HateFindingNames/nICE.Cube/__MAIN_FILE.tex

\documentclass[paper=a4,11pt,titlepage,twoside=true,headings=normal,numbers=noenddot,captions=tableabove,listof=totoc,index=totoc,bibliography=totoc]{scrreprt}
%-----------------------------------------------------------------
\usepackage{etoolbox}
\newbool{deutsch}
\booltrue{deutsch}
%-----------------------------------------------------------------
\input{pre-packages}
\input{pre-variables}
\input{pre-newcommand}
\input{pre-page-layout}
\input{pre-header-footer-2010}
\input{pre-header-footer-text-report}
\DeclareNameAlias{author}{family-given}
\DeclareNameAlias{editor}{family-given}
\DeclareNameAlias{translator}{family-given}
\addbibresource{quellen.bib}
\begin{document}
	%-----------------------------------------------------------------
	\input{chapters/0_top}
	\tableofcontents
	\clearpage
	%-----------------------------------------------------------------
	\input{chapters/1_chap}
	\input{chapters/2_chap}
	\input{chapters/3_chap}
	% \input{chapters/4_chap}
	% \input{chapters/5_chap}
	% \input{chapters/6_chap}
	% \newcommand{\chaptercount}{1} % put number of chapters here
	% \foreach \c in {1,...,\chaptercount}{\input{chapters/\c_chap}}
	%-----------------------------------------------------------------
	% \newpage
	% \listoffigures
	% \listoftables
	% \input{chapters/glossary}
	\appendix
	\input{chapters/appendixA}
	\input{chapters/appendixB}
	\printbibliography
	%=================================================================
\end{document}
