HateFindingNames/nICE.Cube/chapters/1_chap.tex

%LTeX: language=DE-de
\chapter{Zielformulierung}
	Hygienisches, schockabsorbierendes und handliches Kühltransportgefäß mit autarker Energieversorgung und Temperaturregelung für mechanisch und/oder thermisch
	empfindliches medizinisches Transportgut. Es verfügt über eine integrierte Kühllösung, die Temperaturen im Innenbereich von \SI{-20}{\celsius} über
	\(\geq \SI{48}{\hour}\) aufrecht erhalten kann und dabei durch seine kompakte Bauweise von einer einzelnen Person transportiert werden kann.\par\medskip
	Medizinisches Transportgut ist hier im Sinne der des \textit{Medizinischen Produkte Gesetzes} zu verstehen \cite{MPG}.
