HateFindingNames/nICE.Cube/chapters/appendixB.tex

\chapter{Zeichnungen}
	\begin{figure}[h]
		\centering
		
		\caption[Äußere Dimensionen]{Äußere Dimensionen des \textit{nICE.cube}.}
		\label{fig:zeichnung aussen}
	\end{figure}
	\clearpage
	\begin{figure}[h]
		\centering
		
		\caption[Explosionsansicht]{Explosionsansicht und Positionsnummern der Kernkomponenten.}
		\label{fig:explo}
	\end{figure}
	\clearpage
	\begin{figure}[h]
		\centering
		
		\caption[Detailzeichnung des Kühlbehälters.]{Detailzeichnung des Kühlbehälters.}
		\label{fig:nutzvolumen zeichnung}
	\end{figure}
