HateFindingNames/nICE.Cube/Konstruktionsbericht nICE.cube.pdf

HOCHSCHULE RHEINMAIN

### BAUELEMENTE FÜR ENERGIESYSTEME

## Zielformulierung und Konzipierung

## nICE.Cube (Arbeitstitel)

Autoren

CIHAN ÜNLÜ

DENNIS HUNTER

KONSTANTINOS AGLOUPAS

FACHBEREICH INGENIEURWISSENSCHAFTEN

STUDIENBEREICH ANGEWANDTE PHYSIK & MEDIZINTECHNIK

Datum: 31. Juli 2021

## Inhaltsverzeichnis

1 Zielformulierung | 3
2 Produktbeschreibung | 4
3 Detaillierung | 6
A Anhang A | 8
B Zeichnungen | 16
Literatur | 20

## 1 Zielformulierung

Hygienisches, schockabsorbierendes und handliches Kühltransportgefäû mit autarker Energieversorgung und Temperaturregelung für mechanisch und/oder thermisch empfindliches medizinisches Transportgut. Es verfügt über eine integrierte Kühllösung, die Temperaturen im Innenbereich von −20 °C über ≥ 48 h aufrecht erhalten kann und dabei durch seine kompakte Bauweise von einer einzelnen Person transportiert werden kann.
Medizinisches Transportgut ist hier im Sinne der des Medizinischen Produkte Gesetzes zu verstehen [2].

## 2 Produktbeschreibung

Das Transportgefäû -nICE.cube‹ dient dazu, empfindliches Transportgut aus dem medizinischen Bereich mit erhöhten Ansprüchen an die Transportumgebung in ihrem 17 L fassenden Innenraum gekühlt zu lagern. Bedingt durch die hervorragende thermische Dämmung aus Graphen-Aerogel ist das Produkt in der Lage, bei 40 °C Auûentemperatur eine Innentemperatur von −20 °C unter Abwesenheit einer aktiven Kühlung über einen Zeitraum von 5 h ohne kritischen Temperaturanstieg zu halten.
Eine aktive Kühlung wird durch einen 12 V Kompressor vom Typ CASCADE des Herstellers MASTER-FLUX bereit gestellt. Die Spannungsversorgung erfolgt im Stützbetrieb wahlweise durch Anbindung per Kaltgerätesteckverbindung an ein 230/110 V 50/60 Hz AC Netz oder eine 12 V-24 V Gleichstromquelle.

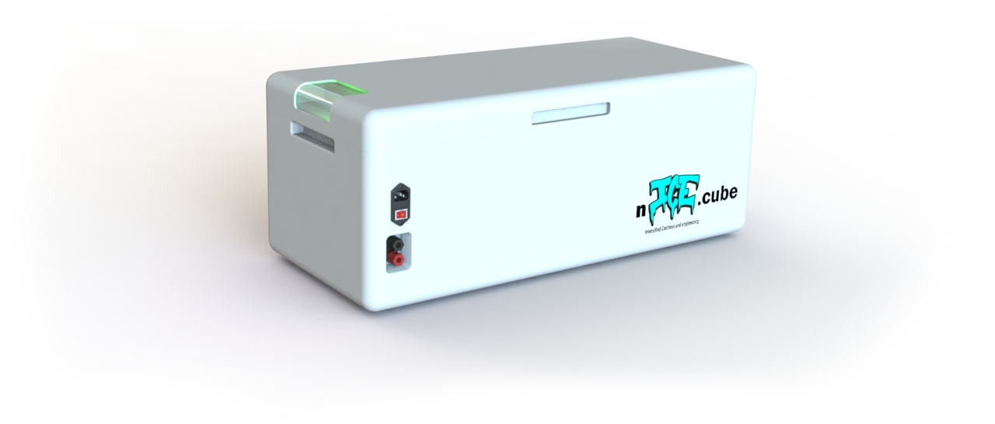
[picture p2: figure]

Abb. 2.1: Transport- und Kühleinheit nICE.cube.

Um einen autarken Betrieb von mindestens 48 h aufrecht zu erhalten ist ein 74W h Li-Ion-Akku verbaut. Um im mobilen Einsatz auch bei längeren Transportwegen die Kühlung sicher gewährleisten zu können, kann das Produkt von anderen -nICE.cube‹ parallel versorgt oder durch das mitgelieferte Photovoltaikmodul, welches eine Spitzenleistung von 250Wp liefert, gespeiût werden.
Am besonders energieeffizienten eInk-Display lassen sich jederzeit Parameter wie Innentemperatur, Akkustand Auûentemperatur oder geschätze Restlaufzeit¹ kontrollieren. Erreicht der Innenbereich eine vom Benutzer gesetzte kritische Temperatur oder einen niedrigen Akkustand wird über sich am Display befindliche Pieper und LEDs wahlweise akustisch und/oder visuell alarmiert.
Während die Schalung aus ABS-Kunststoff Komponenten wie Elektronik, Akku und Kompressor vor mechanischen Umwelteinflüssen schützt, sorgt die Schock- und Vibrationsdämpfende Aufhängung des Innenbereichs für einen sicheren Transport auch im Gelände.

1
In Abhängigkeit der historischen Auûentemperatur und momentanem Akkustand.

Hochschule RheinMain

## 2.1 Technische Daten

Die technischen Daten des -nICE.cube‹ im Überblick:

Tab. 2.1: Technische Daten

Mechanisch
Äuûere Dimensionen | 813 x 358 x 314 (LxBxH, Einheiten in mm)
Nutzvolumen | 16, 72 L
Gesamtgewicht | 22 kg

Elektrisch
Kapazität Akku | 72W h
Versorgungsspannung AC | 230/110 V 50/60 Hz
Versorgungsspannung DC | 12 − 24 V
Kühlleistung | 27, 65W [6]
Studienbereich Angewandte Physik & Medizintechnik | 5 von 20

## 3 Detaillierung

Die Transporteinheit nICE.cube erfüllt den Zweck, Krisengebiete mit extremen Wetterbedingungen mit Medikamente und Impfstoffe zu versorgen, indem das Kühlgut sicher transportiert werden kann.
Die Kühlung des Nutzvolumens erfolgt durch eine Kompressionskälteanlage mit einer maximalen Kühlleistung von 27, 65W. Die zentrale Komponente bildet hier ein Kompressor der CASCADE-Serie des Herstellers Masterflux ± ein in seiner Klasse besonders energieeffizientes und spezifisch für den Einsatz im medizinischen Sektor entwickeltes Gerät.
Die hervorragende thermische Isolation des Primärvolumens durch Graphen-Aerogel (vgl. table A.4) reduziert die Betriebszeiten der Kälteanlage und damit den Energiebedarf des nICE.cube auf ein Minimum. Zum autarken Betrieb ist ein Energiespeicher bestehend aus 32 Li-Ion-Zellen der Bauform 18650 verbaut. In 4S8P-Konfiguration liefern sie eine nominelle Versorgungsspannung der Systemkomponenten von 14, 8 V bei einer Gesamtkapazität von 296W h 1
. Die bereits geringe Belastung des Energiespeichers durch Entladeströme je Zelle bei Volllast von ≈ 0, 25 A wird durch thermische Überwachung jeder Einzelzelle garantiert. Über die Lebensdauer hinweg werden Lade- und Entladezyklen sowie Ströme und Spannungsverläufe aufgezeichnet, um die Nutzenden jederzeit über den Zustand des Akkus informieren zu können.
Die Ladung erfolgt wahlweise stationär durch das lokale AC-Versorgungsnetz oder im mobilen Einsatz durch Anschluss eines Photovoltaikmoduls. Die äuûeren Dimensionen des nICE.cube betragen (813×358×
314) mm (LxBxH). Als Nutzvolumen steht mit Abmessungen von ≈ (400 × 248 × 173) mm ein Volumen von 16, 72 L zur Verfügung.

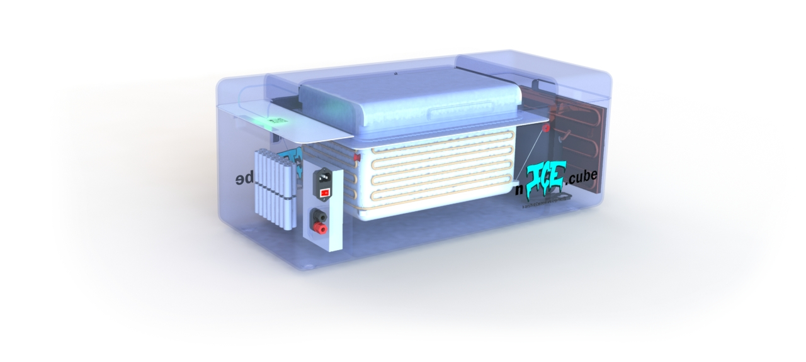
[picture p3: figure]

Abb. 3.1: Konzeptansicht des nICE.cube mit Blick auf die innenliegenden Komponenten.

1Reduktion durch Verschleiû/Nutzungsverhalten möglich.

## 3.1 Stückliste

Tab. 3.1: Stückliste (vgl. fig. B.2)

Pos. | Menge Einheit Benennung | Bemerkung
1 | 1 | Stk. | Ansaugverbindung
2 | 4 | Stk. | Aramidschnur
3 | 1 | Stk. | Druckreduzierer
4 | 2 | Stk. | Durchführung
5 | 1 | Stk. | Dämpfer
6 | 1 | Stk. | E-Ink Display | 1.54"
7 | 1 | Stk. | Ein-/Ausgabepanel
8 | 4 | Stk. | Elektronik
9 | 1 | Stk. | Elektronikdeckel
10 | 1 | Stk. | Gummimanschette
11 | 1 | Stk. | Hülle
12 | 1 | Stk. | Kompressor | CASCADE17-0146Y1
13 | 1 | Stk. | Kompressordeckel
14 | 1 | Stk. | Kältemittelverbindung von
| | | Verflüssiger
15 | 1 | Stk. | Kältemittelverbindung zu
| | | Verflüssiger
16 | 32 | Stk. | Li-Ion 18650 | 4S8P Konfiguration
17 | 1 | Stk. | Reduzierer
18 | 1 | Stk. | Transportgutbehälter
19 | 1 | Stk. | Trockner
20 | 1 | Stk. | Verflüssiger
21 | 1 | Stk. | Verschlussdeckel auûen
22 | 1 | Stk. | Verschlussdeckel innen
23 | 1 | Stk. | DC-Anschluss | Buchse für 4, 2 mm Laborstecker mit
| | | | Polschraube (Bipolar)
24 | 1 | Stk. | AC-Anschluss | C14 AC Buchse mit Schalter und Si-
| | | | cherungshalter

## A Anhang A

## A.1 Pflichtenheft

Tab. A.1: Liste mit Festanforderungen.

Festanforderungen | Erläuterung
Hygienisch | Das Material muss Kontamination durch Verkeimung
| oder Ähnlichem weitestgehend unterbinden. Die Geo-
| metrie muss eine einfache und gründliche Reinigung
| ermöglichen.
Thermisch geregelt | Die Innentemperatur muss einstellbar sein und einem
| Regelkreis unterliegen.
Thermische Isolierung | Die innere Temperatur muss weitgehend stabil gehal-
| ten werden.
Autarke Energieversorgung | Erneuerbare Energien nutzend muss das Gerät über ei-
| ne eigene Spannungsversorgung verfügen.
Integrierter Energiespeicher | Im Offline-Betrieb und bei Ausfall der eigenen Span-
| nungsversorgung muss das Produkt betriebsfähig blei-
| ben.
Cradle-to-cradle | Sämtliche verbauten Komponenten müssen einem
| biologischen oder technischen Kreislauf zurückge-
| führt werden können.
Kompakte und leichte Bauweise | Das Produkt muss beladen von einer Einzelperson
| transportiert werden können.
Schockfreie Lagerung des Inhalts | Der Nutzraum muss von starken Erschütterungen ent-
| koppelt sein.
Alarmierung bei kritischer Temperatur | Die Nutzenden müssen über kritische Temperaturzu-
| stände informiert werden.
Alarmierung bei kritischem Akkustand | Die Nutzenden müssen über kritische Energieversor-
| gung informiert werden.

Tab. A.2: Liste nicht zu unter- oder gegebenenfalls überschreitender Parameter.

Mindestanforderungen | Erläuterung
Kühlung ≤ (−20 ± 1) °C | Der Innenraum muss auf mindestens −20 °C herun-
| tergekühlt werden können.
Temperaturstabil ≥ 48 h | Die Temperatur muss min. 48 h lang gehalten werden.
Gewicht ≤ 20 kg | Die Box soll ein Leergewicht von max. 20 kg besit-
| zen.

## A.2 Marktforschung

Es wurden Marktforschungen betrieben, um eine Übersicht der konkurrierenden Kühlboxen zu erhalten.

Tab. A.3: Liste von Eigenschaften, die das Produkt im Rahmen der Machbarkeit weiterhin aufweisen könnte.

Wunschanforderungen | Erläuterung
Innenbeleuchtung | Bei schlechter Auûenbeleuchtung sollte der Inhalt
| dennoch gut erkennbar sein.
Statusanzeige | Die Nutzenden sollen sich jederzeit über den Status
| des Produktes ± Temperatur, Leistungsaufnahme und
| -abgabe, Restkapazität ± informieren können.
Modularer Aufbau | Einzelne funktionale Komponenten sollen leicht aus-
| tauschbar sein.
Verbundbetrieb | Mehrere der Produkte sollen im Verbund betrieben
| werden können. Hierzu zählt Stützbetrieb einzelner
| Geräte durch andere, sowie gesammelte Statusanzei-
| ge.
Kompatibilität verschiedener ext. Span- nungsversorgungen | Das Gerät soll an möglichst vielen verschiedenen
| externen Versorgungsspannungen betrieben werden
| können.

T0022 FDN von EBERSPÄCHER (https://www.eberspaecher-klima.de/fileadmin/data/corporatesite/pdf/de/4_air_conditioning/gp/fh_gp_kuehlcontainer_de.pdf)

- Temperatur von −24 °C
- Spannung 12 V / 24 V DC
- (65 − 70) mm PU Wandausschämung
- Kältemittel R134a (Tetrafluorethan)
- Gewicht von 20, 5 kg
- Auûenabmessung 375 x 585 x 480 (BxTxH, Einheiten in mm)

ICY 20 von FRIGOLAB COLD TECHNOLOGY (https://www.frigolab.eu/gb/dometic-portable-freezers/67-icy-20.html)

- Temperaturen von −18 °C bis 10 °C.
- Auûenabmessung 515 x 345 x 425 (BxTxH, Einheiten in mm).
- Digitales Display.
- Kühlung durch einen Kompressor.
- Kältemittel R134a (Tetrafluorethan).
- Versorgung von 12 V / 24 V DC oder 230 V AC.
- Gewicht von 18 kg.
- Resistent gegen Schock und mechanische Belastungen.
- CFC- und HCF-freie Polyurethanschaum.

TC 702 von TRITEC (https://www.tritec-klima.de/datenblaetter/de/kaelte/portable/TD-TC702.pdf)

- Temperaturen von −24 °C bis 10 °C.

- Auûenabmessung 375 x 585 x 480 (B x T x H, Einheiten in mm).
- Durch Autobatterie mit 12 V / 24 V DC betrieben.
- Umschalter für Netzbetrieb (230 V AC).
- Stabiler und stoûfester UVA-beständiger Kunststoff.
- Deckel mit spezieller Verriegelung.
- Dämmung mit FCKW-feiem PU-Hartschaum von 80 mm Dicke.
- Reinigungsmittelresistent.
- Alarmmeldungen bei möglichen Fehlern des Gerätes.
- Kompressor mit einem R52A Kältemittelgemisch.

T0022/T0032 von COLDTAINER (https://coldtainerusa.com/wp-content/uploads/2020/03/Product_Info_T0022-T0032_US_ColdtainerUSA-1.pdf)

- Temperatur von −24 °C bis 40 °C
- Spannungsversorgung 12 / 24 V DC
- (65 − 70) mm PU-Wandausschämung
- Kältemittel R134a (Tetrafluorethan)
- Gewicht von 20, 5 kg
- ≈ 23 L Kapazität

## A.3 Mindmap

Nach den ersten Überlegungen zu den Anforderungen und Funktionen des Transportgefäûes kann eine Übersicht anhand eines Mindmaps wie in Abb. A.1 gestaltet werden.

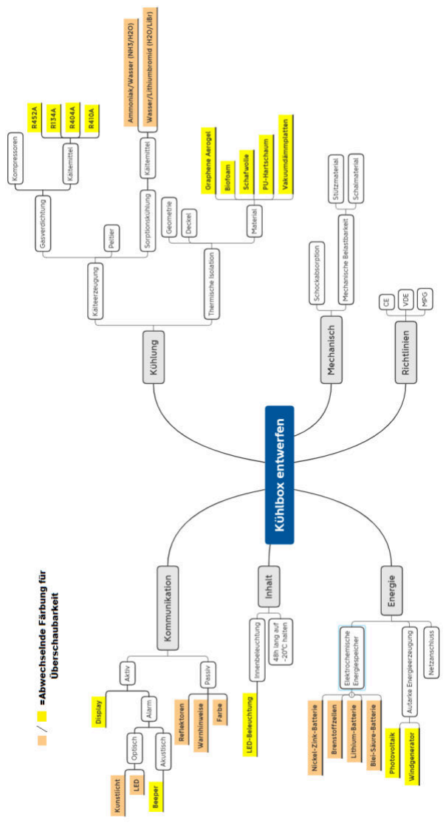
[picture p4: figure]

Abb. A.1: Mindmap.

## A.4 Materialien und Regularien

A.4.1 Normen und Regularien

Dem BUNDESINSTITUT FÜR ARZNEIMITTEL UND MEDIZINPRODUKTE zu Folge ist „ein Absehen von
der Genehmigung einer klinischen Prüfungª [1] möglich, wenn das Produkt etwa den Medizinprodukten der Klasse I zuzuordnen ist [2]. Die Klassifizierung von medizinischen Produkten wiederum ist durch die
Richtlinie 93/42/EWG geregelt. In Anhang IX ist zu lesen:

„Alle nicht invasiven Produkte gehören zur Klasse I [..]ª [3]

mit Ausnahme derer nicht-invasiven Produkte, die in folgenden Punkten aufgeführten Regelungen Anwendung finden. Es ist anzunehmen, dass dies hier nicht der Fall ist.

Dennoch handelt es sich um ein Gerät, dass, um für den europäischen Markt zugelassen werden zu können eine CE-Kennzeichnung benötigt und somit die damit verbundenen Auflagen erfüllen muss. Die relevante Norm scheint hier DIN EN 60601.
Weiter wird eine VDE-Kennzeichnung benötigt, da es sich um ein in einer Form elektrisch betriebenes Gerät handelt. Dies wird um so relevanter, wenn ein Betrieb an Netzspannung möglich oder vorgesehen ist.

A.4.2 Auswahl Dämmmaterialien

Tab. A.4: Übersicht möglicher Materialien zur thermischen Dämmung.

(Handels-)Name | λ/ mW m·K | ρ/ mg
cm³ | E-Modul / kP a Druckfestigk. / kP a
Luft | 25, 7 | 1, 2041 | ± | ±
Graphen/Silizium Aerogel [5] 7, 3 ± 9 | (2, 4 ± 4)·10³
Biofoam (Algen) [7] | | 30
Biobasiertes PU [4] | 33 | 18, 5 | 176, 7 | 15, 4
Air laid feather fibre [10] | 30¹ | | | > 30²
Vakuumdämmplatte [8] | 37 ± 31 16, 3 ± 59, 4

1Bei −10 °C
2Nach 10 minütigem Eintauchen in flüssigen Stickstoff (−195 °C)

## A.5 Überschlagsrechnung Energiebedarf

Annahme: 20 L Innenraum; zu 80 % gefüllt mit Wasser (16 L=16 kg b )

Betrachtung: Energien beim Herunterkühlen von Wasser bei RT (20 °C = 293 K) auf −20 °C = 253 K

Je kg umgewandelte Wärmeenergie = Änderung der spezifischen Enthalpie:

Für 20 °C → 0 °C:

∆h1 =

∆Q1
m

= cW asser · (T0 − T20) = 4, 19

kJ
kg K | (A.1)

= −83

kJ
kg | (A.2)

Zum Erstarren:

∆h2 = herstarr,W asser = −hfus,W asser
= −334 kJ
kg | (A.3)

Für 0 °C → −20 °C:

∆h3 = cEis · (T−20 − T0) = 2, 0

kJ
kg K · (253 K − 273 K)

= −40 kJ
kg | (A.4)

∆hges = ∆h1 + ∆h2 + ∆h3 = −83, 8

kJ

kg − 334 kJ

kg − 40 kJ
kg = −457, 8

kJ
kg

⇒ ∆Qges = ∆hges · m = −457, 8

kJ
kg · 16 kg
= −7324, 8 kJ ≈ −7, 3 MJ | (A.5)

Benötigte Energie, um eine Temperaturdifferenz aufrechtzuerhalten:
Mit einer Schichtdicke des thermischen Isoliermaterials von l = 0, 05 m, der Gesamtfläche A des Kühlraums von ≈ 0, 208 m² und einer thermischen Leitfähigkeit von λ = 7, 3

mW
| m K lässt sich der thermische
Widerstand zu Rth ≈ 33 K
W abschätzen.

Rth =

l
λ · A

=

0, 05 m
7, 3

mW
m K · 0, 208 m²

≈ 33

K
W
| (A.6)

Q˙ = P =

(Taussen − Tinnen)

Rth

=

313, 15 K − 253, 15 K

### 33 K

W
≈ 1, 81W | (A.7)
⇒ ≈ 87, 27W h | (Für 48 h)

Bei einer Auûentemperatur von 40 °C und einer Anfangsinnentemperatur von −20 °C mit der Annahme, dass 33 % des Nutzvolumens von 16, 72 L mit Wasser und 66 % mit Luft gefüllt sind, wird von einer Dauer von tkrit = 14, 2 h ausgegangen, bis sich der Innenraum um 2 K erwärmt hat.

tkrit =

∆T
Q˙
- [(0, 66 · ρaqV · caq) + (0, 33 · ρluftV · cluft)]

=

### 2 K

1, 81W

·

- 0, 66 · 1000
kg
m³
- 0, 0167 m³
- 4200 J

kg K

+

0, 33 · 1, 225

kg
m³
- 0, 0167 m³
- 1005

J

kg K

≈ 51.159 s ≈ 14, 2 h | (A.8)

∆T =

∆Q
0, 66 · ρaqV · caq

=

1, 81W · 5 h · 3600 s
h
0, 66 · 997 kg
m³ · (16, 72 · 10⁻³) m³ · 4200 J
kg K
≈ 0, 7 K | (A.9)

## A.6 Dimensionierung Photovoltaikmodul

Mithilfe der Photovoltaik kann der Akku bei Tageslicht geladen und die Kühlung somit aufrecht erhalten werden. Hierbei ist einem monokristallines PV-Modul bei einer Fläche von 9 m²
eine Spitzenleistung von
mindestens 1 kWp zu entnehmen [9]. Zum Betrieb des nICE.cube und Laden seines Energiespeichers ist ein Viertel der Leistung (=250W b p) ausreichend. Dies entspricht einer effektiven Fläche von 2, 25 m²

## A.7 Volumenberechnung

Das Nutzvolumen setzt sich aus der Länge L, Breite B und Höhe H der inneren Box zusammen.

Vnutz = L · B · H
= 4, 00 dm · 2, 48 dm · 1, 73 dm
= 17, 16 L | (A.10)

Im Sinne thermischer und mechanischer Optimierung wurden Verrundungen mit r = 4 mm entlang der Innenkanten des Nutzvolumens platziert. Diese reduzieren das effektive Nutzvolumen auf 16, 72 L.

## A.8 Elektronik

Die Verbindung der jeweiligen Elektronikkomponenten wird in fig. A.2 schematisch dargestellt.

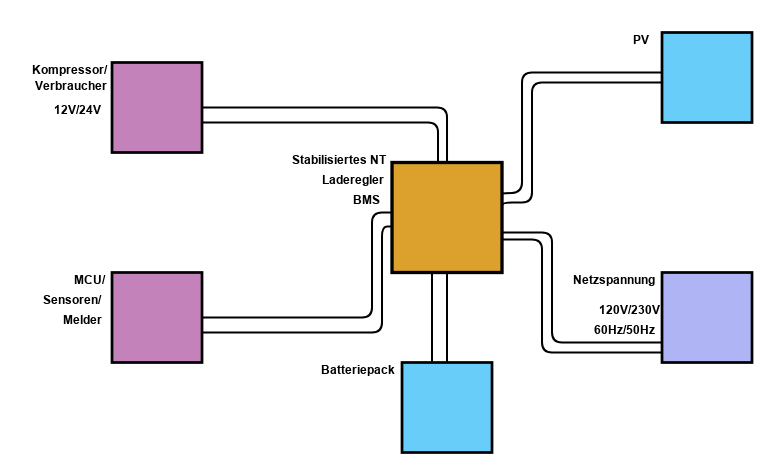
[picture p5: figure]

Abb. A.2: Schaltschema der Elektronik.

Sowohl die interne als auch sämtliche externe Spannungsversorgungen werden vom internen Netzteil auf den Lastkreis von 12 V, sowie die Versorgungsspannung der Boardelektronik geregelt. Das im Netzteil integrierte Batteriemanagement übernimmt hierbei die Überwachung des Akkuzustandes. Daten wie Auûenund Innentemperatur, Temperatur der Akkuzellen, Statistiken zum Zustand des Akkus etc. laufen zentral im

Mikrocontroller zusammen, werden dort verarbeitet und gegebenenfalls an die Meldesysteme weitergegeben.
Um Raum einzusparen und das Kühlkonzept der Boardelektronik zu vereinfachen wurden in der Realisierung Mikrocontroller, Batteriemanagement und Netzteil in einem Bauteil vereint (Pos. 8 in table 3.1).

## B Zeichnungen

# Hochschule RheinMain 813

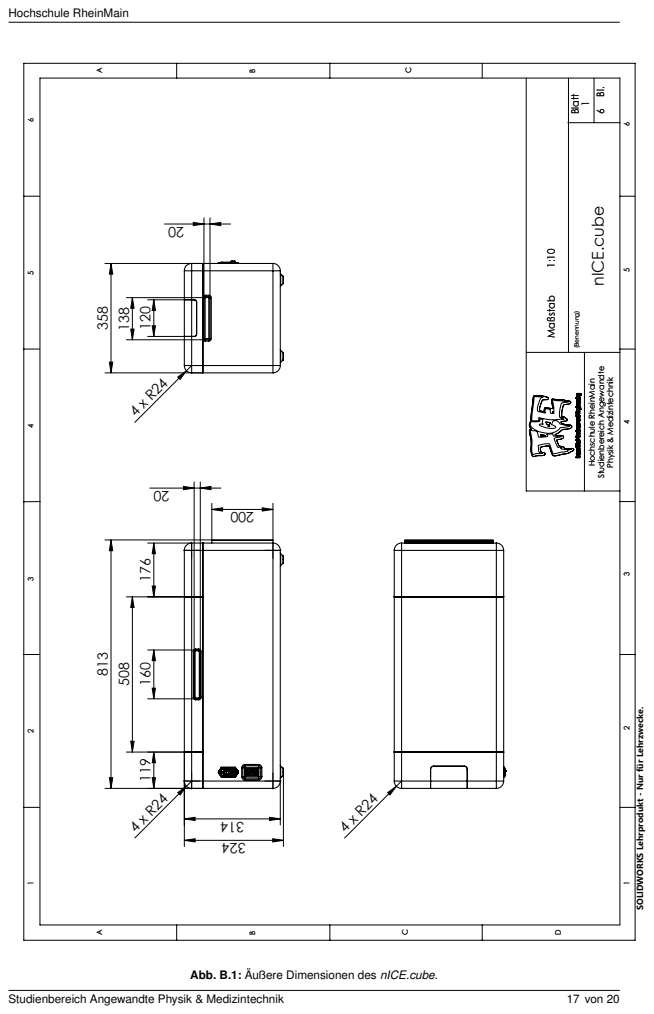
[picture p6: page 17]
Maßstab 1:10; Hochschule RheinMain; Studienbereich Angewandte Physik & Medizintechnik; (Benennung) Blatt; nICE.cube

SOLIDWORKS Lehrprodukt - Nur für Lehrzwecke.

Abb. B.1: Äuûere Dimensionen des nICE.cube.

5

22 19

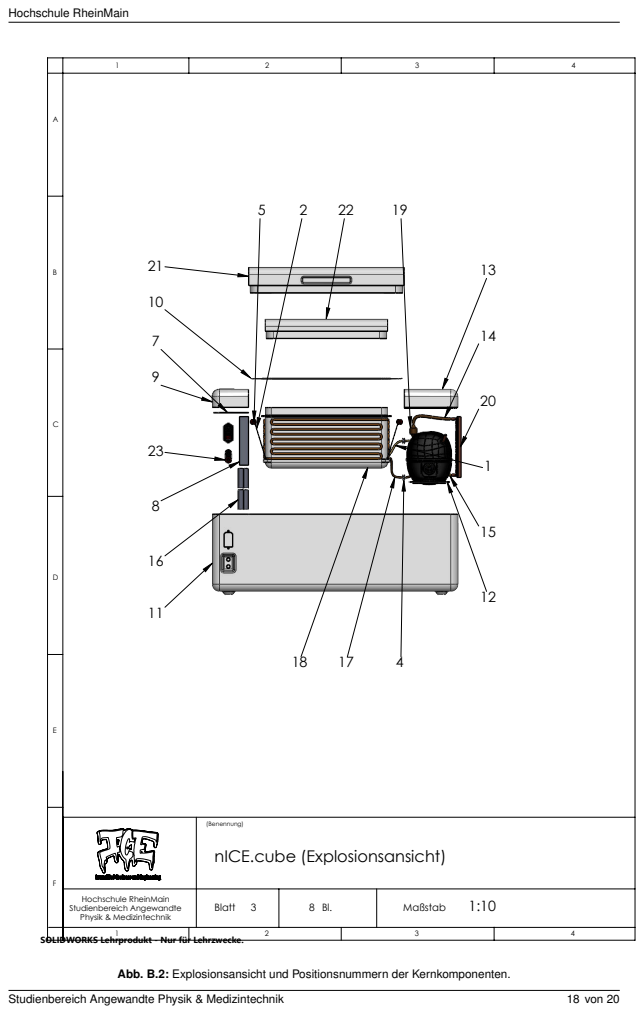
[picture p7: page 18]
Maßstab; Blatt

(Benennung)
nICE.cube (Explosionsansicht)

Hochschule RheinMain
Studienbereich Angewandte
Physik & Medizintechnik
SOLIDWORKS Lehrprodukt - Nur für Lehrzwecke.

Abb. B.2: Explosionsansicht und Positionsnummern der Kernkomponenten.

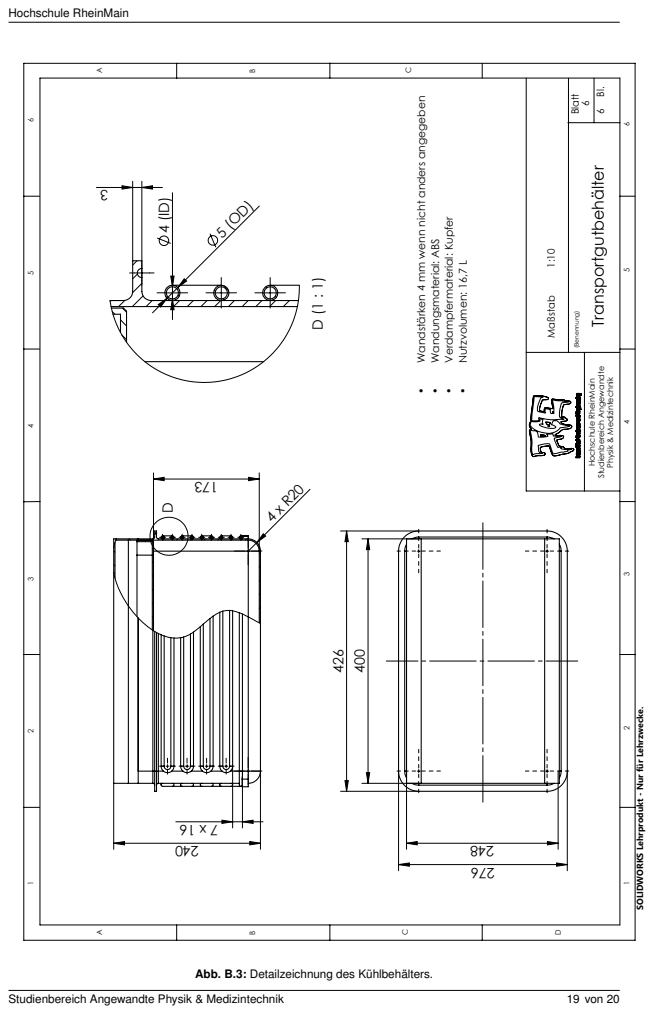
[picture p8: page 19]
Wandungsmaterial: ABS •; Verdampfermaterial: Kupfer •; Nutzvolumen: 16,7 L •; Maßstab 1:10; Hochschule RheinMain; Studienbereich Angewandte Physik & Medizintechnik; (Benennung) Blatt; Transportgutbehälter

Wandstärken 4 mm wenn nicht anders angegeben •

SOLIDWORKS Lehrprodukt - Nur für Lehrzwecke.

Abb. B.3: Detailzeichnung des Kühlbehälters.

## Literatur

[1] BfArM. Antrag auf Absehen von der Genehmigungspflicht. URL: https://www.bfarm.de/DE/Medizinprodukte/KlinischePruefung/AbsehenVonDerGenehmigungspflicht/
_node.html (https://www.bfarm.de/DE/Medizinprodukte/KlinischePruefung/AbsehenVonDerGenehmigungspflicht/_node.html) (besucht am 07. 05. 2021).
[2] Bundesrepublik Deutschland. Medizinische Produkte Gesetz. MPG. 7. Mai 2021. URL: https://
www.gesetze-im-internet.de/mpg/index.html#BJNR196300994BJNE001903377
(besucht am 07. 05. 2021).
[3] European Council. Council Directive 93/42/EEC. Version 1993L0042 Ð EN Ð 11.10.2007 Ð 005.001.

### 14. Juni 1993. URL: https://eur-lex.europa.eu/legal-content/EN/TXT/?qid=

1620368811646&uri=CELEX%3A01993L0042-20071011 (https://eur-lex.europa.eu/legal-content/EN/TXT/?qid=1620368811646&uri=CELEX%3A01993L0042-20071011) (besucht am 05. 05. 2021).
[4] Huang, X., Qi, J., De Hoop, C., Xie, J., and Chen, Y. Biobased polyurethane foam insulation from mi-
crowave liquefaction of woody underbrush. NC State University, 2017. URL: https://bioresources.cnr.ncsu.edu/wp- content/uploads/2017/09/BioRes_12_4_8160_Huang_ QHXC _ Biobased _ PU _ Foam _ Insulation _ Liquefaction _ Woody _ Underbrush _
12704.pdf (https://bioresources.cnr.ncsu.edu/wp-content/uploads/2017/09/BioRes_12_4_8160_Huang_QHXC_Biobased_PU_Foam_Insulation_Liquefaction_Woody_Underbrush_12704.pdf) (besucht am 02. 05. 2021).
[5] Lei, Yaofei u. a. „Enhancements of thermal insulation and mechanical property of silica aerogel monoliths by mixing graphene oxideª. In: Materials Chemistry and Physics 187 (2017). PII: S0254058416308975,
S. 183±190. ISSN: 02540584. DOI: 10.1016/j.matchemphys.2016.11.064. (https://doi.org/10.1016/j.matchemphys.2016.11.064)
[6] Masterflux. Datenblatt CASCADE17-0146Y1. URL: https://www.masterflux.com/userimages/CASCADE17-0146Y1_DATA_SHEET.pdf (https://www.masterflux.com/userimages/CASCADE17-0146Y1_DATA_SHEET.pdf) (besucht am 27. 07. 2021).
[7] Morrison, Robert L. „Biofoam II. US19940215159;US19930043300ª. C08J9/00;C08J9/28;C08J9/26;C08J9/28. US5360828 (A) (US). UNIV CALIFORNIA. 1994.
[8] Nagarajan, Venkata S. und Grieco, William J. „VACUUM INSULATED PANEL. US201314067025ª. F16L59/07;B32B37/10;E04C2/02. US2015118434 (A1) (US). OWENS CORNING INTELLECTU-AL CAP. 2015.
[9] Wesselak, Viktor und Voswinckel, Sebastian. Photovoltaik. Wie Sonne zu Strom wird. ger. Technik im Fokus. Berlin: Springer Vieweg, 2012. 129 S. ISBN: 978-3-642-24297-7.
[10] Zhao, Yuanxiang, Dieckmann, Elena und Cheeseman, Christopher. „Low-temperature thermal insulation materials with high impact resistance made from feather-fibresª. In: Materials Letters: X 6 (2020). PII: S2590150820300028, S. 100039. ISSN: 25901508. DOI: 10.1016/j.mlblux.
2020.100039. (https://doi.org/10.1016/j.mlblux.2020.100039)
