HateFindingNames/nICE.Cube/pre-header-footer-text-report.tex

% le --> links, gerade Seite
% ce --> mittig, gerade Seite
% re --> rechts, gerade Seite
% lo --> links, ungerade Seite
% co --> mittig, ungerade Seite
% ro --> rechts, ungerade Seite
% even --> gerade Seite
% odd --> ungerade Seite
%----------------------------------------- Kopfzeilentext
 \newcommand{\titelkopfzeilemitteeven}{}
 \newcommand{\titelkopfzeilemitteodd}{}
 \newcommand{\titelkopfzeilelinkseven}{Hochschule RheinMain}
 \newcommand{\titelkopfzeilelinksodd}{Hochschule RheinMain}
 \newcommand{\titelkopfzeilerechtseven}{}
 \newcommand{\titelkopfzeilerechtsodd}{}
 %----------------------------------------- Fußzeilentext
 \newcommand{\titelfusszeilemitteeven}{}
 \newcommand{\titelfusszeilemitteodd}{}
 \newcommand{\titelfusszeilerechtseven}{\thepage \hspace{0.5mm} von \pageref{LastPage}}
 \newcommand{\titelfusszeilerechtsodd}{\thepage \hspace{0.5mm} von \pageref{LastPage}}
 \newcommand{\titelfusszeilelinkseven}{Studienbereich Angewandte Physik \& Medizintechnik}
 \newcommand{\titelfusszeilelinksodd}{Studienbereich Angewandte Physik \& Medizintechnik}
