HateFindingNames/nICE.Cube/chapters/5_chap.tex

%LTeX: language=DE
\chapter{Energieversorgung und -speicher}
{
\centering
\includepdf[pages=-]{Wartungsfreie_Batterien_und_PV.pdf}
}
