HateFindingNames/nICE.Cube/chapters old/2_chap.tex

% %LTeX: language=DE
% \chapter{Marktforschung}
%     Es wurden Marktforschungen gemacht, um bei den aktuellen Kühlboxen nach einen potenzielle Konkurrent zu finden.
%     \href{https://www.eberspaecher-klima.de/fileadmin/data/corporatesite/pdf/de/4_air_conditioning/gp/fh_gp_kuehlcontainer_de.pdf}{\textsc{Ebersprächer}}
%     \begin{figure}[h] %[H h t b]
%         \centering
%         \includegraphics[width=.5\textwidth]{referenzen/eberspächer.jpg}
%         \caption{Kühlbox t0022 FDN von Eberspächer}
%     \end{figure}
%     \href{https://www.frigolab.eu/gb/dometic-portable-freezers/67-icy-20.html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}{\textsc{FrigoLab cold technology}}
%     \begin{figure}[h] %[H h t b]
%         \centering
%         \includegraphics[width=.5\textwidth]{referenzen/FrigoLab.jpg}
%         \caption{Kühlbox ICY 20 von FrigoLab cold technology}
%     \end{figure}
%     \href{https://www.tritec-klima.de/datenblaetter/de/kaelte/portable/TD-TC702.pdf}{\textsc{Tritec}}
%     \begin{figure}[h] %[H h t b]
%         \centering
%         \includegraphics[width=.5\textwidth]{referenzen/tritec.jpg}
%         \caption{Kühlbox TC 702 von Tritec}
%     \end{figure}
%     \href{https://coldtainerusa.com/wp-content/uploads/2020/03/Product_Info_T0022-T0032_US_ColdtainerUSA-1.pdf}{\textsc{Coldtainer}}
%     \begin{figure}[h] %[H h t b]
%         \centering
%         \includegraphics[width=.5\textwidth]{referenzen/coldtainer.png}
%         \caption{Kühlbox T0022/T0032 von Coldtainer}
%     \end{figure}
%     \newpage
%     Bei der Marktforschung wird oft nicht angegeben über die Dauer der Kühlung und verlässt sich stark auf die Wärmedämmung des Inhalts. Von der momentane Auwashl
%     ist die Kühlbox von Tritec, die unsere Forerungen am ehesten erfüllt.

%LTeX: language=DE
\chapter{Marktforschung}
Es wurden Marktforschungen gemacht, um bei den aktuellen Kühlboxen nach einen potenzielle Konkurrent zu finden.\par\medskip

\textbf{T0022 FDN von} \href{https://www.eberspaecher-klima.de/fileadmin/data/corporatesite/pdf/de/4_air_conditioning/gp/fh_gp_kuehlcontainer_de.pdf}{\textsc{Eberspächer}}
\begin{figure}[H] %[H h t b]
    \centering
    
    \caption{Kühlbox t0022 FDN von \textsc{Eberspächer}.}
\end{figure}
\begin{itemize}
    \item Temperatur von \SI{-24}{\celsius}
    \item Spannung 12 / \SI{24}{V} DC
    \item \SI{(65-70)}{mm} PU Wandausschämung
    \item Kältemittel R134a (Tetrafluorethan)
    \item Gewicht von \SI{20,5}{kg}
    \item Außenabmessung \(\SI{(375 x 585 x 480)}{mm}\) (BxTxH)
\end{itemize}
\newpage
\textbf{ICY 20 von} \href{https://www.frigolab.eu/gb/dometic-portable-freezers/67-icy-20.html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}{\textsc{FrigoLab Cold Technology}}
\begin{figure}[H] %[H h t b]
    \centering
    
    \caption{Kühlbox ICY 20 von \textsc{FrigoLab Cold Technology}.}
\end{figure}
\begin{itemize}
    \item Temperaturen von \SI{-18}{\celsius} bis \SI{10}{\celsius}.
    \item Außenabmessung \SI{(515 x 345 x 425)}{mm} (BxTxH).
    \item Digitales Display.
    \item Kühlung durch einen Kompressor.
    \item Kältemittel R134a (Tetrafluorethan).
    \item Versorgung von 12 / \SI{24}{V} DC oder \SI{230}{V} AC.
    \item Gewicht von \SI{18}{kg}.
    \item Resistent gegen Schock und mechanische Belastungen.
    \item CFC- und HCF-freie Polyurethanschaum.
\end{itemize}
\newpage
\textbf{TC 702 von} \href{https://www.tritec-klima.de/datenblaetter/de/kaelte/portable/TD-TC702.pdf}{\textsc{Tritec}}
\begin{figure}[H] %[H h t b]
    \centering
    
    \caption{Kühlbox TC 702 von \textsc{Tritec}.}
\end{figure}
\begin{itemize}
    \item Temperaturen von \SI{-24}{\celsius} bis \SI{10}{\celsius}.
    \item Außenabmessung \SI{(375 x 585 x 480)}{mm} (B x T x H).
    \item Durch Autobatterie mit 12 / \SI{24}{V} DC betrieben.
    \item Umschalter für Netzbetrieb (\SI{230}{V} AC).
    \item Stabiler und stoßfester UVA-beständiger Kunststoff.
    \item Deckel mit spezieller Verriegelung.
    \item Dämmung mit FCKW-feiem PU-Hartschaum von \SI{80}{mm} Dicke.
    \item Reinigungsmittelresist.
    \item Alarmmeldungen bei möglichen Fehlern des Gerätes.
    \item Kompressor mit einem R52A Kältemittelgemisch.
\end{itemize}

\newpage
\textbf{T0022/T0032 von} \href{https://coldtainerusa.com/wp-content/uploads/2020/03/Product_Info_T0022-T0032_US_ColdtainerUSA-1.pdf}{\textsc{Coldtainer}}
\begin{figure}[H] %[H h t b]
    \centering
    
    \caption{Kühlbox T0022/T0032 von \textsc{Coldtainer}.}
\end{figure}
\begin{itemize}
    \item Temperatur von \SI{-24}{\celsius} bis \SI{40}{\celsius}
    \item Spannungsversorgung 12 / \SI{24}{V} DC %volt of direct current bzw. Gleichstrom
    \item \SI{(65-70)}{mm} PU Wandausschämung
    \item Kältemittel R134a (Tetrafluorethan)
    \item Gewicht von \SI{20,5}{kg}
    \item \(~ \SI{23}{L}\) Kapazität
\end{itemize}
