HateFindingNames/nICE.Cube/assets/skizzen/Mindmap.png

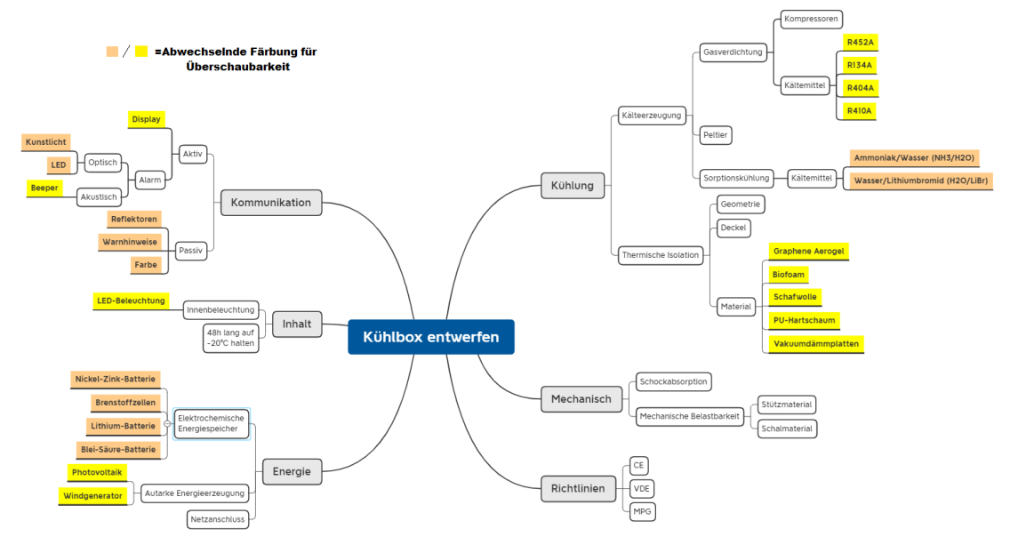
assets/skizzen/Mindmap.png
