HateFindingNames/nICE.Cube/Assembly/assy.SLDASM

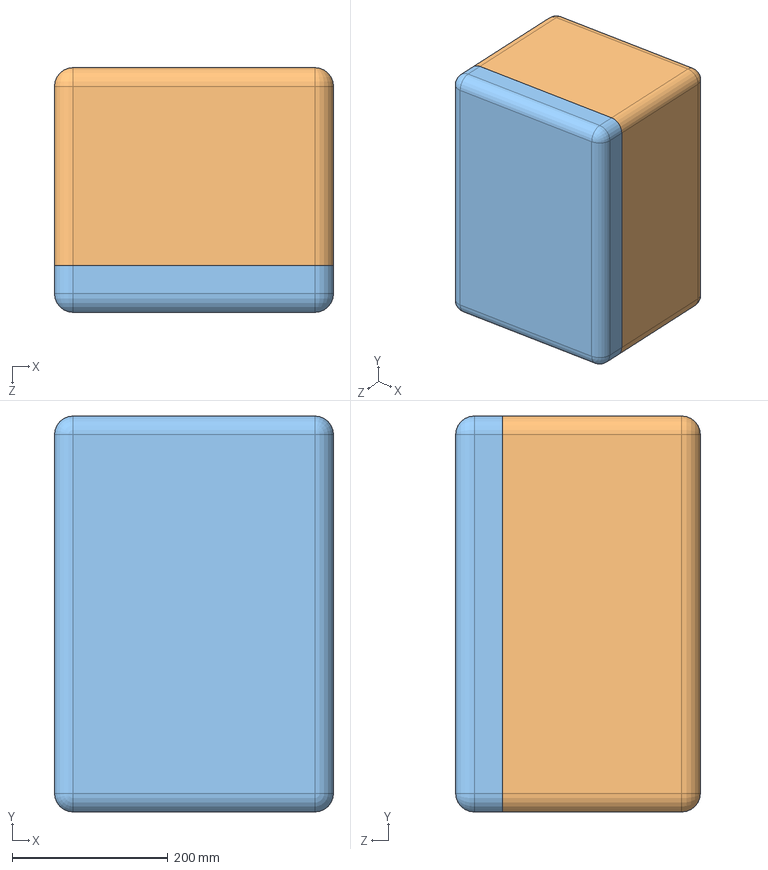
[picture p10: CAD file, 2021-05-20]
Assembly/assy.SLDASM
358.0 x 508.0 x 314.0 mm
Inner_compartement
Outer Shell^assy
deckel x 2
