HateFindingNames/nICE.Cube/Assembly/deckel innen.SLDPRT

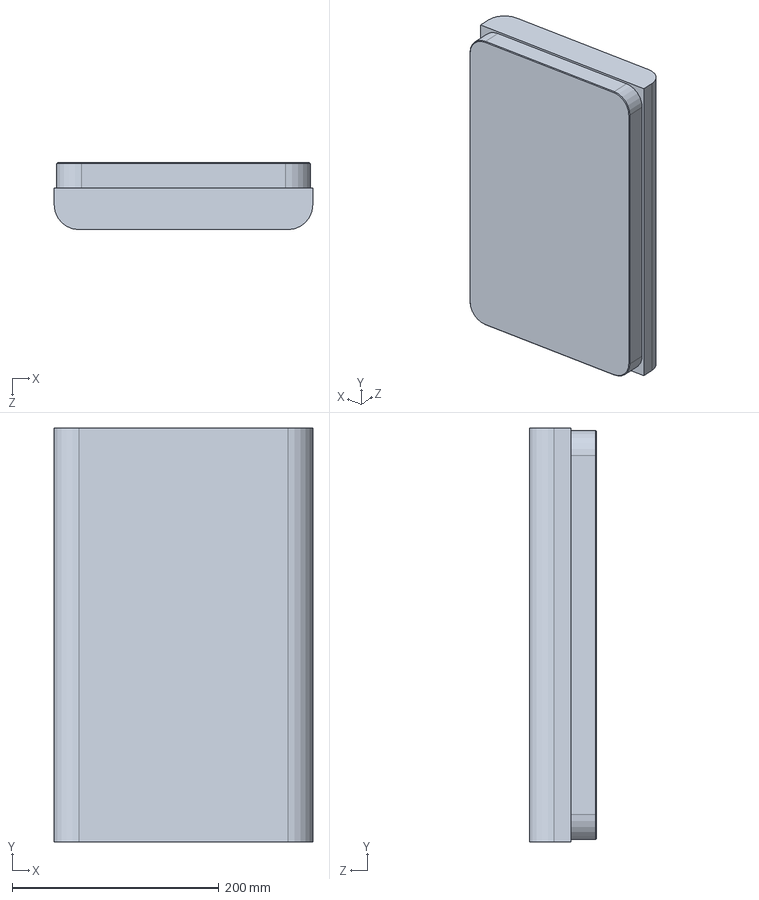
[picture p11: CAD file, 2021-07-30]
Assembly/deckel innen.SLDPRT
250.0 x 400.0 x 65.0 mm
