HateFindingNames/nICE.Cube/Assembly/parts/electronics/AC_Power_Socket-3_pin_250V_10A_AC-17.SLDPRT

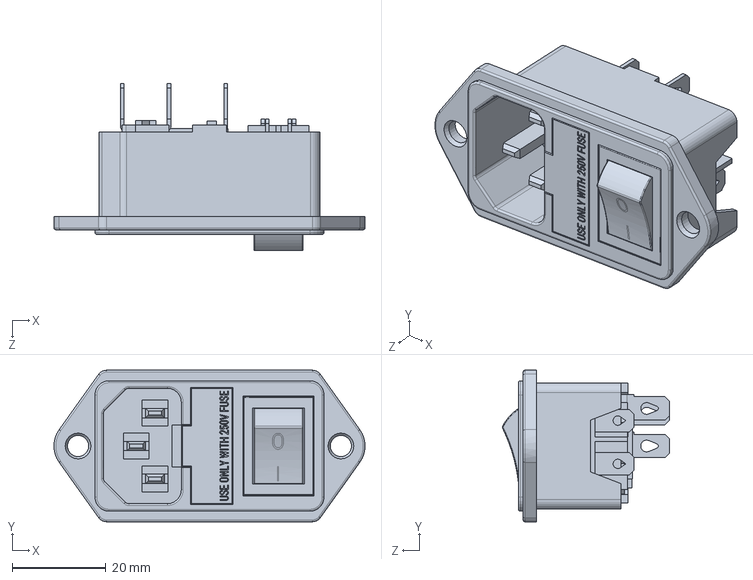
[picture p12: CAD file, 2021-07-30]
Assembly/parts/electronics/AC_Power_Socket-3_pin_250V_10A_AC-17.SLDPRT
66.3 x 32.3 x 35.6 mm
