HateFindingNames/nICE.Cube/Assembly/deckel aussen.SLDPRT

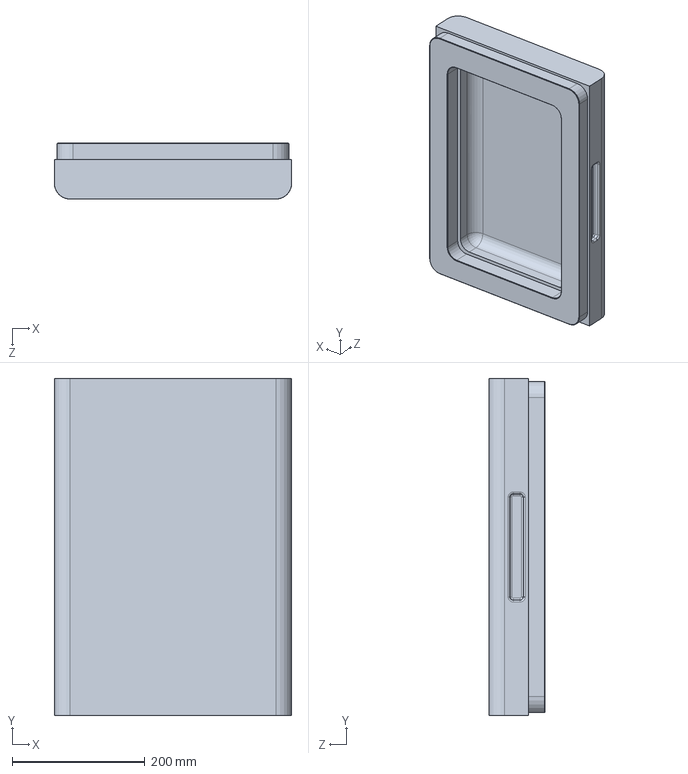
[picture p13: CAD file, 2021-07-30]
Assembly/deckel aussen.SLDPRT
358.0 x 508.0 x 85.0 mm
