HateFindingNames/nICE.Cube/Assembly/parts/electronics/Dual_connector.SLDPRT

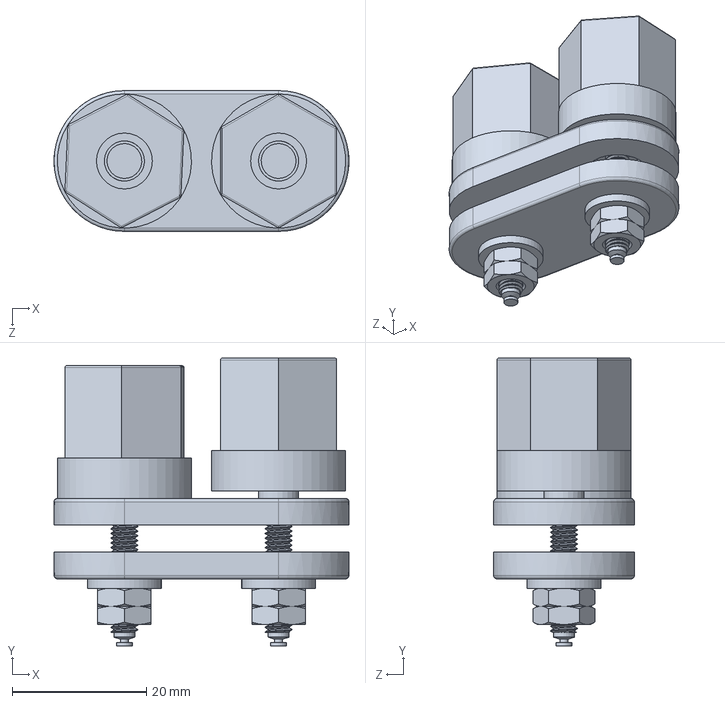
[picture p14: CAD file, 2021-07-30]
Assembly/parts/electronics/Dual_connector.SLDPRT
44.0 x 42.9 x 21.0 mm
