HateFindingNames/nICE.Cube/Assembly/Inner_compartement.SLDPRT

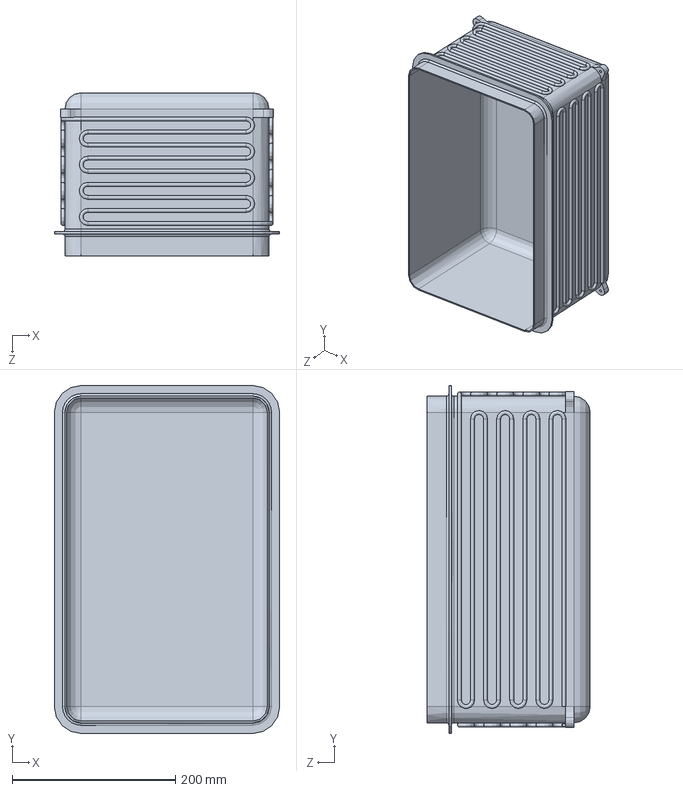
[picture p15: CAD file, 2021-07-30]
Assembly/Inner_compartement.SLDPRT
276.0 x 426.0 x 200.0 mm
