HateFindingNames/nICE.Cube/Assembly/outer_shell.SLDPRT

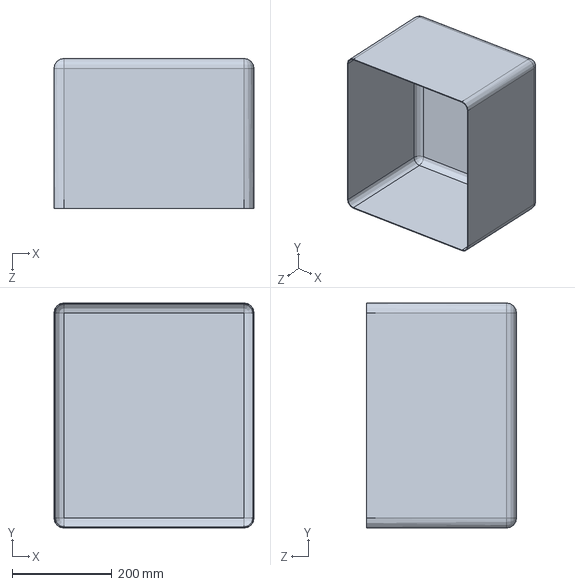
[picture p16: CAD file, 2021-05-20]
Assembly/outer_shell.SLDPRT
400.0 x 450.0 x 300.0 mm
