HateFindingNames/nICE.Cube/Assembly/deckel.SLDPRT

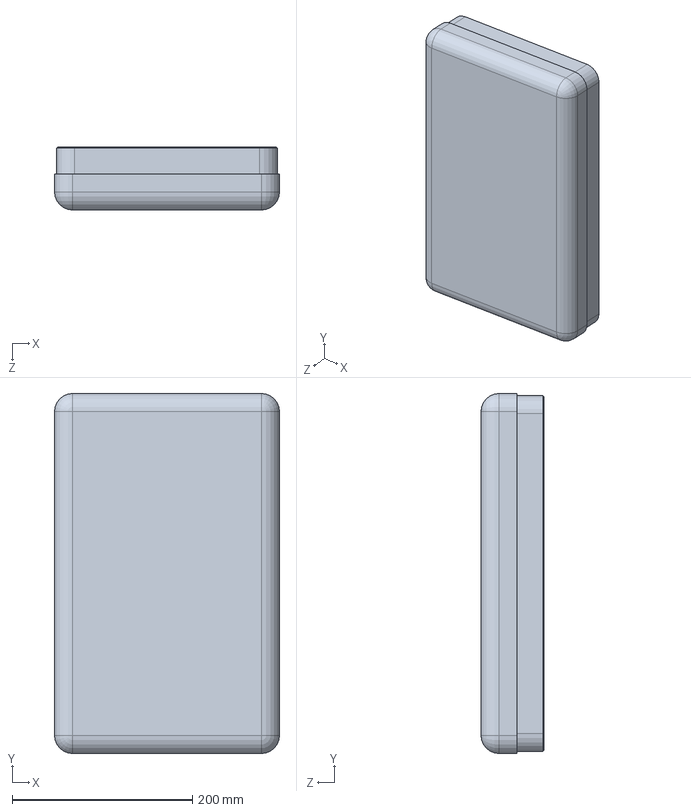
[picture p17: CAD file, 2021-05-20]
Assembly/deckel.SLDPRT
250.0 x 400.0 x 70.0 mm
