HateFindingNames/nICE.Cube/(list of files, cad)

Other CAD files:
Assembly/assy.SLDDRW
