HateFindingNames/nICE.Cube/Assembly/nutzvolumen_zeichnung.PDF

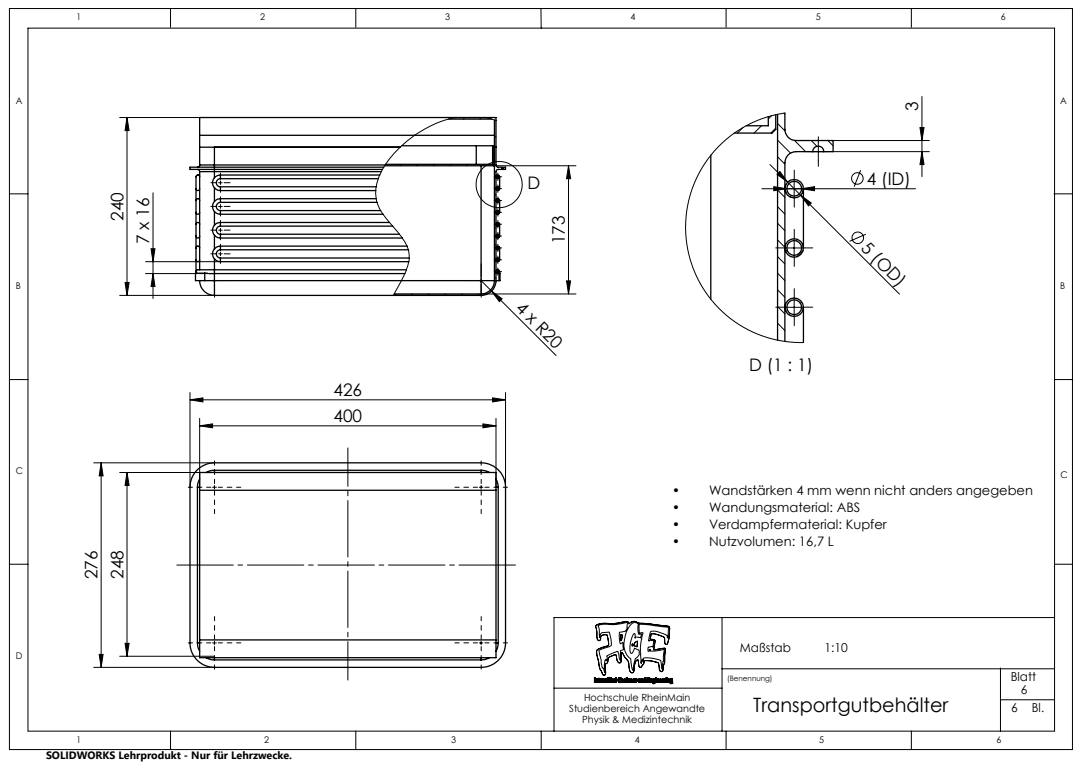
[picture p18: page 1]
Hochschule RheinMain Studienbereich Angewandte Physik & Medizintechnik

• Wandstärken 4 mm wenn nicht anders angegeben
• Wandungsmaterial: ABS
• Verdampfermaterial: Kupfer
• Nutzvolumen: 16,7 L

SOLIDWORKS Lehrprodukt - Nur für Lehrzwecke.
