HateFindingNames/nICE.Cube/Assembly/assy.pdf

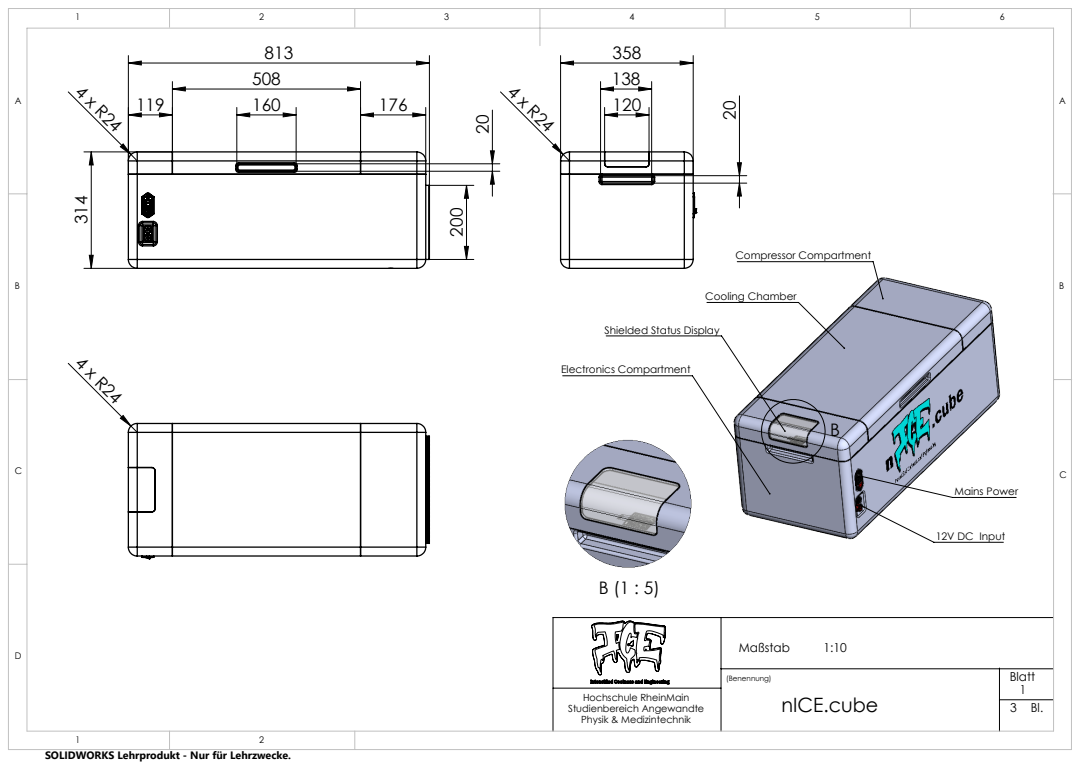
[picture p19: page 1]
Compressor Compartment; Cooling Chamber; Electronics Compartment; Mains Power; 12V DC Input; Hochschule RheinMain Studienbereich Angewandte Physik & Medizintechnik

Shielded Status Display

Maßstab 1:10
(Benennung) nICE.cube | Blatt 1

SOLIDWORKS Lehrprodukt - Nur für Lehrzwecke.

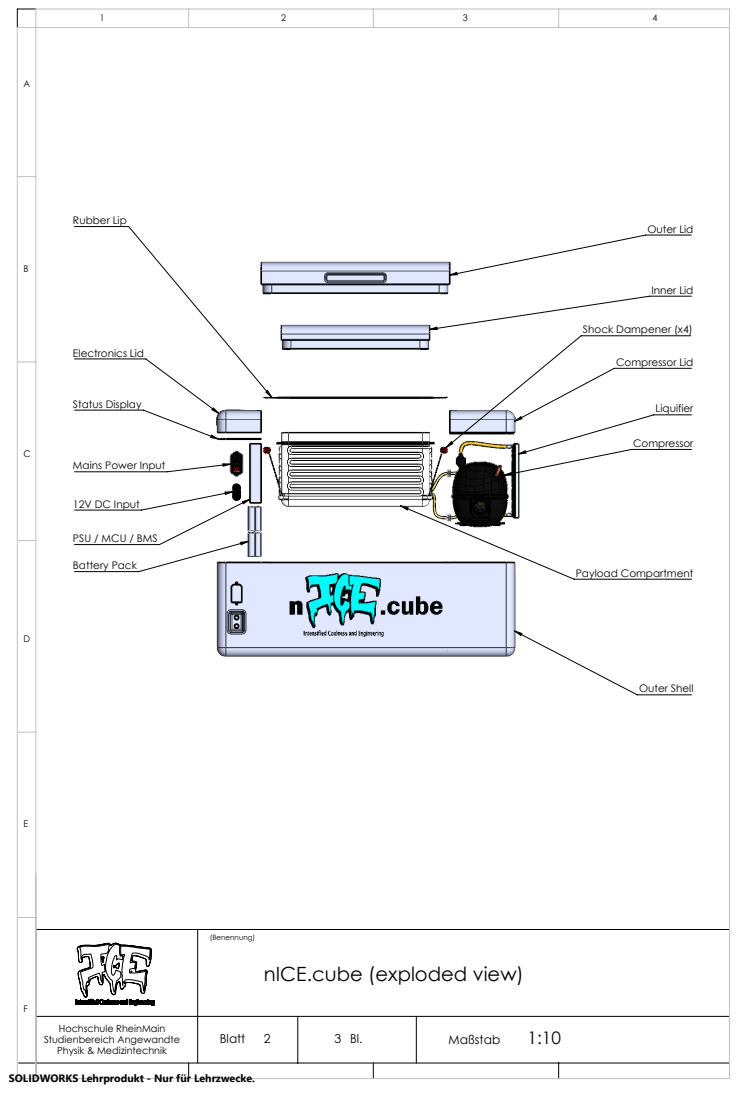
[picture p20: page 2]
Outer Lid; Inner Lid; Compressor Lid; Shock Dampener (x4); Electronics Lid; 12V DC Input; Payload Compartment; Rubber Lip; Outer Shell; Status Display; Hochschule RheinMain; Blatt 2

Mains Power Input

PSU / MCU / BMS
Battery Pack

(Benennung)
nICE.cube (exploded view)

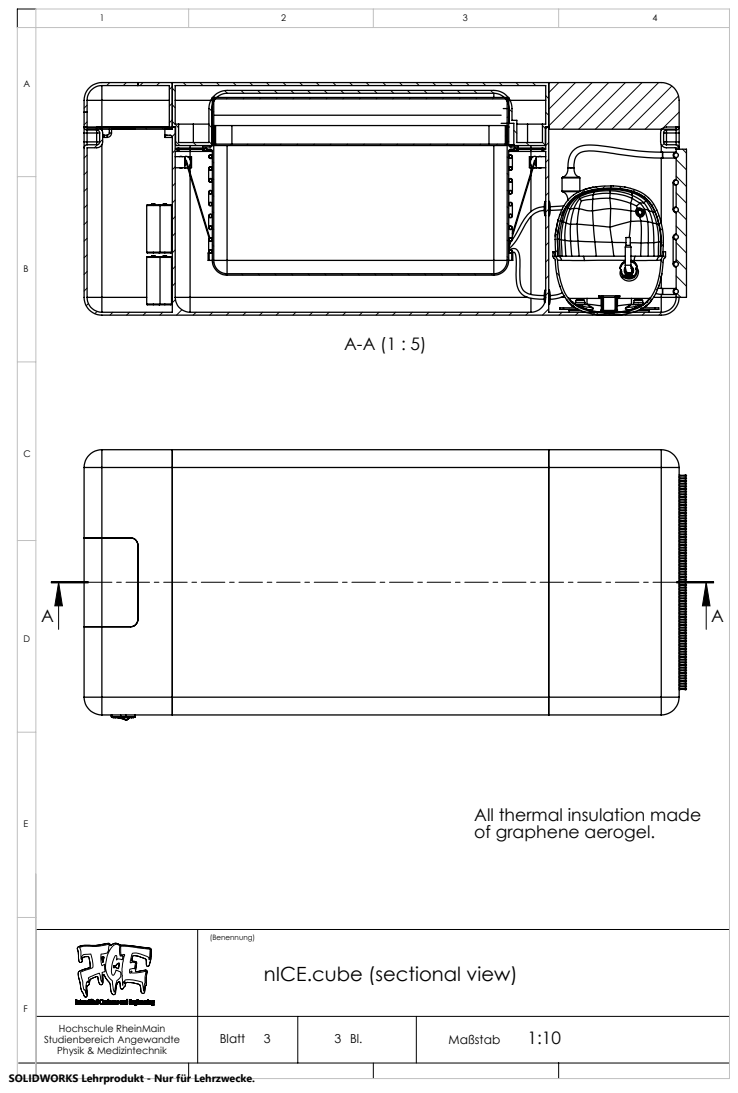
[picture p21: page 3]
Hochschule RheinMain; Blatt 3

All thermal insulation made
of graphene aerogel.

(Benennung)
nICE.cube (sectional view)
