HateFindingNames/nICE.Cube/Assembly/aussen_zeichnung.PDF

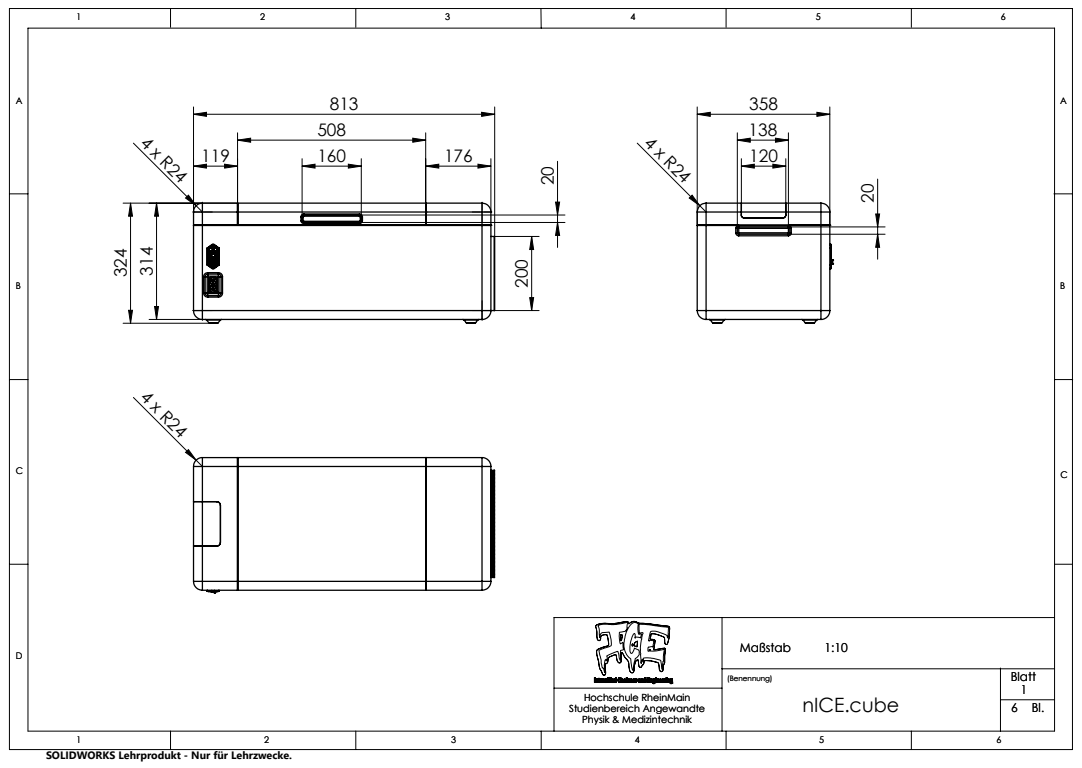
[picture p22: page 1]
Hochschule RheinMain Studienbereich Angewandte Physik & Medizintechnik

SOLIDWORKS Lehrprodukt - Nur für Lehrzwecke.
