HateFindingNames/nICE.Cube/(commit log)

2021-05-02 Insulation materials
2021-05-20 new stuff
    [Inner_compartement.SLDPRT, assy.SLDASM, assy.SLDDRW, deckel.SLDPRT, outer_shell.SLDPRT]
2021-07-30 CAD files added
    [AC_Power_Socket-3_pin_250V_10A_AC-17.SLDPRT, Dual_connector.SLDPRT, Inner_compartement.SLDPRT, deckel aussen.SLDPRT, deckel innen.SLDPRT]
2021-07-30 updated CAD
    [deckel aussen.SLDPRT, deckel innen.SLDPRT]
